ozonisator/OpenLRSng_SI4432/Bilder/OpenLRSng v0.2 Funkmodul.jpg

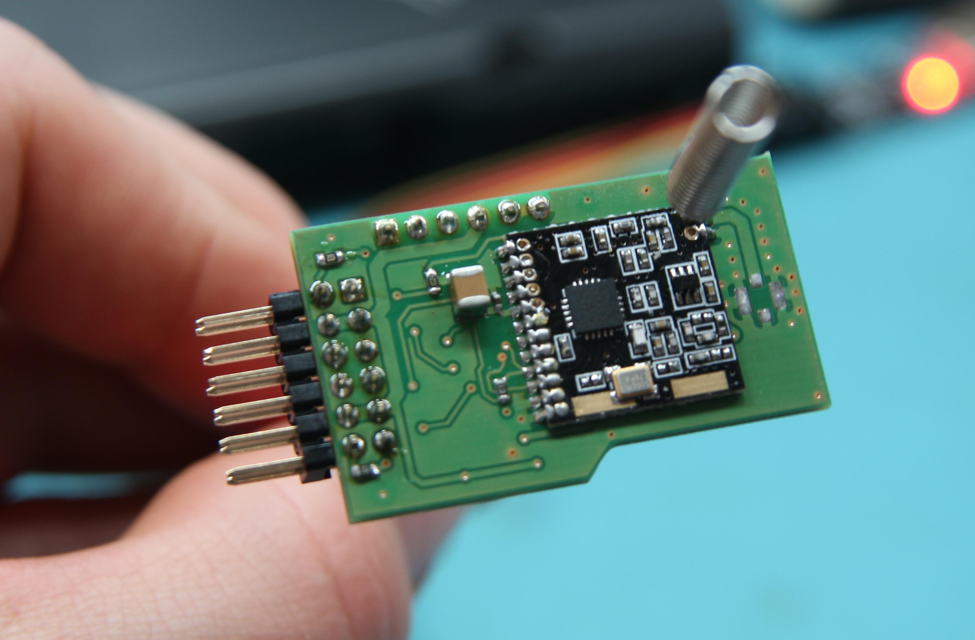
Bilder/OpenLRSng v0.2 Funkmodul.jpg
