ozonisator/OpenLRSng_SI4432/Bilder/OpenLRSng v0.2 Atmel.jpg

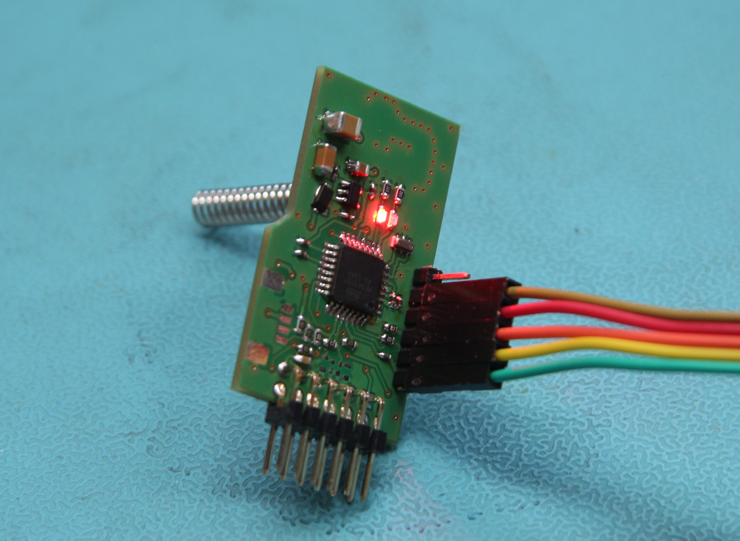
Bilder/OpenLRSng v0.2 Atmel.jpg
