ozonisator/OpenLRSng_SI4432/README.md

OpenLRSng Empfänger mit SI4432 Breakoutboard. Kompatibel zu "DTFUHF 4ch RX"
