ozonisator/OpenLRSng_SI4432/OpenLRSng_SI4432.pdf

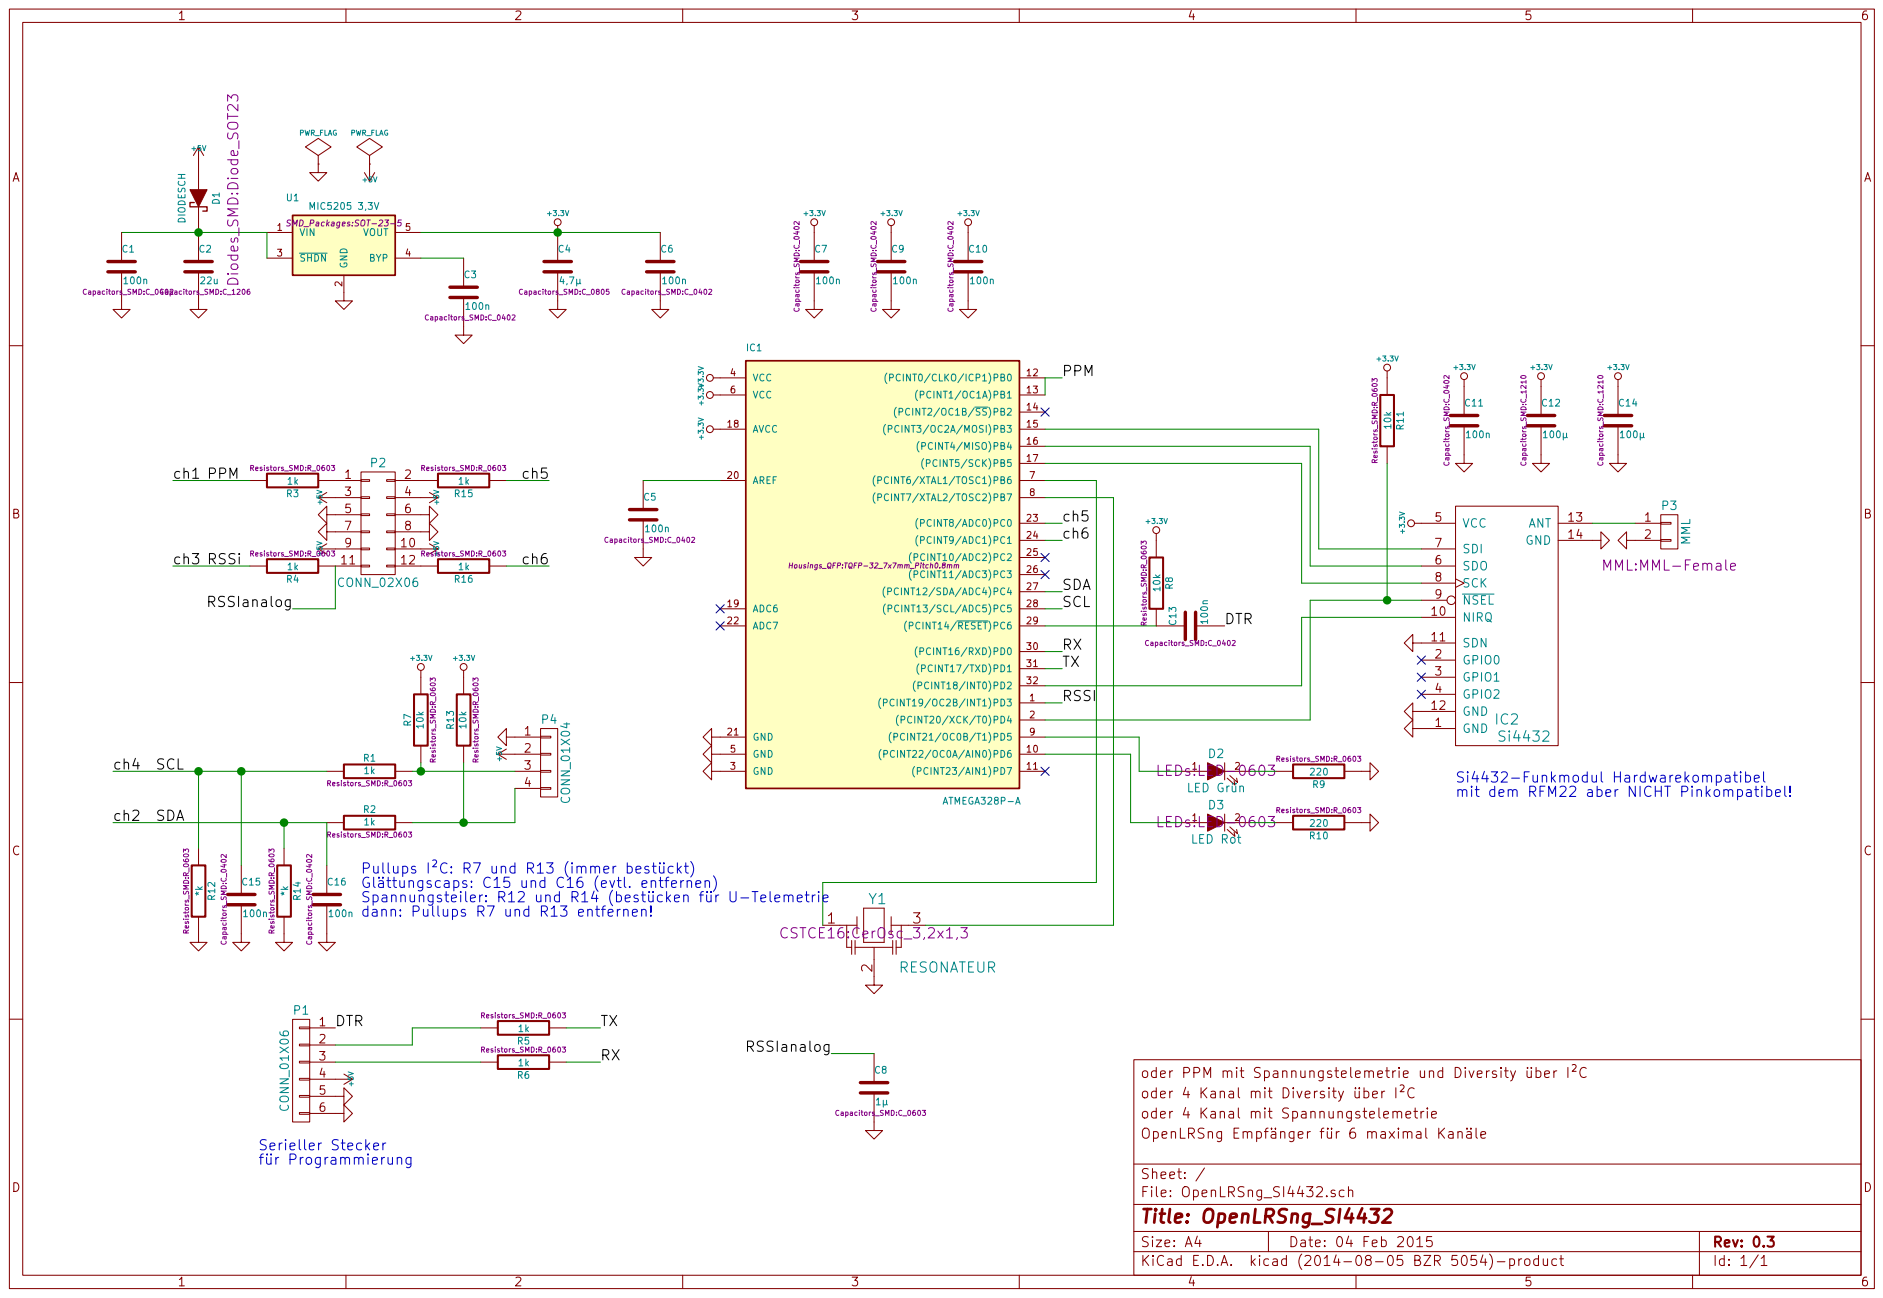
[picture p4: page 1]

dann: Pullups R7 und R13 entfernen! ch1

2 P3 MML MML:MML-Female

LED Grün LEDs:LED-0603

LED Rot LEDs:LED-0603

Glättungscaps: C15 und C16 (evtl. entfernen)
Spannungsteiler: R12 und R14 (bestücken für U-Telemetrie

oder PPM mit Spannungstelemetrie und Diversity über I²C
oder 4 Kanal mit Diversity über I²C
oder 4 Kanal mit Spannungstelemetrie
File: OpenLRSng_SI4432.sch Sheet: / OpenLRSng Empfänger für 6 maximal Kanäle
