ozonisator/OpenLRSng_SI4432/OpenLRSng_SI4432.kicad_pcb

## KiCad design OpenLRSng_SI4432.kicad_pcb (2015-02-28)

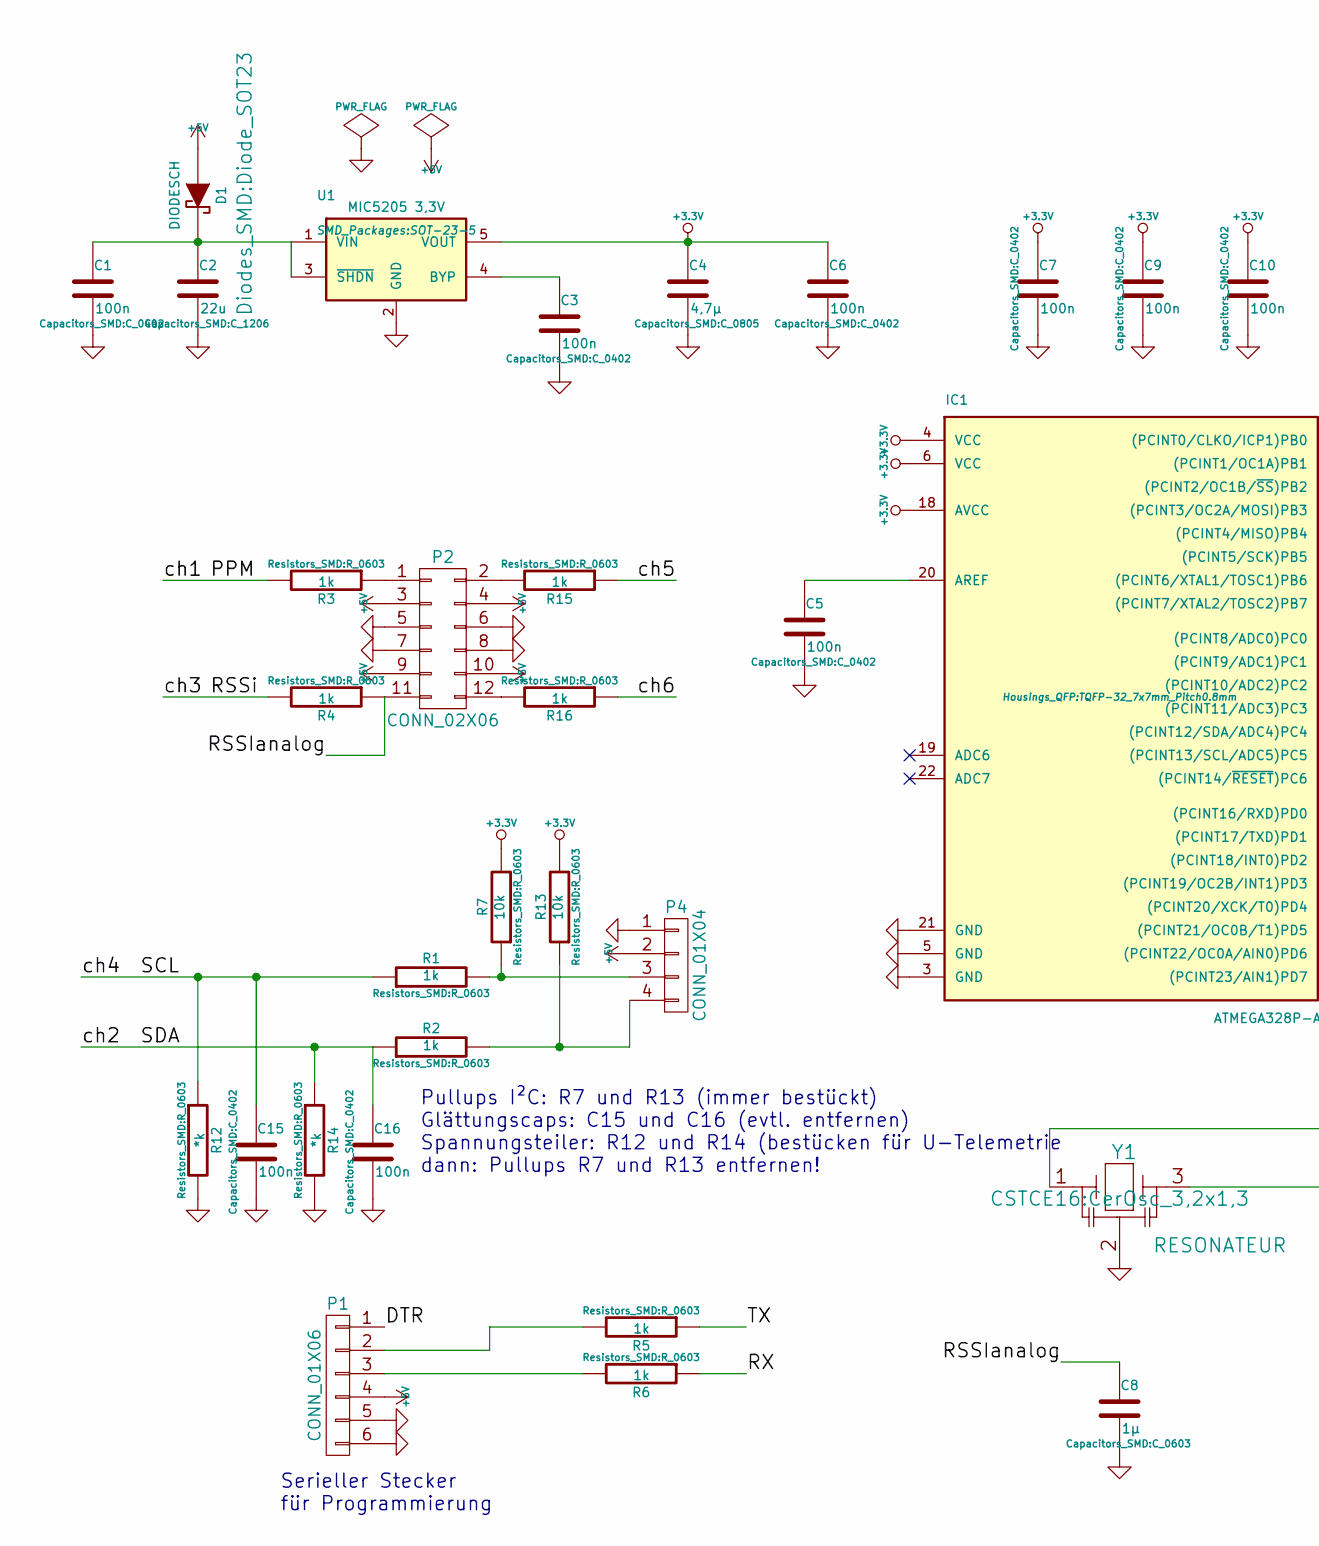
[picture p5: schematic OpenLRSng_SI4432.sch, part in row 1, column 1]

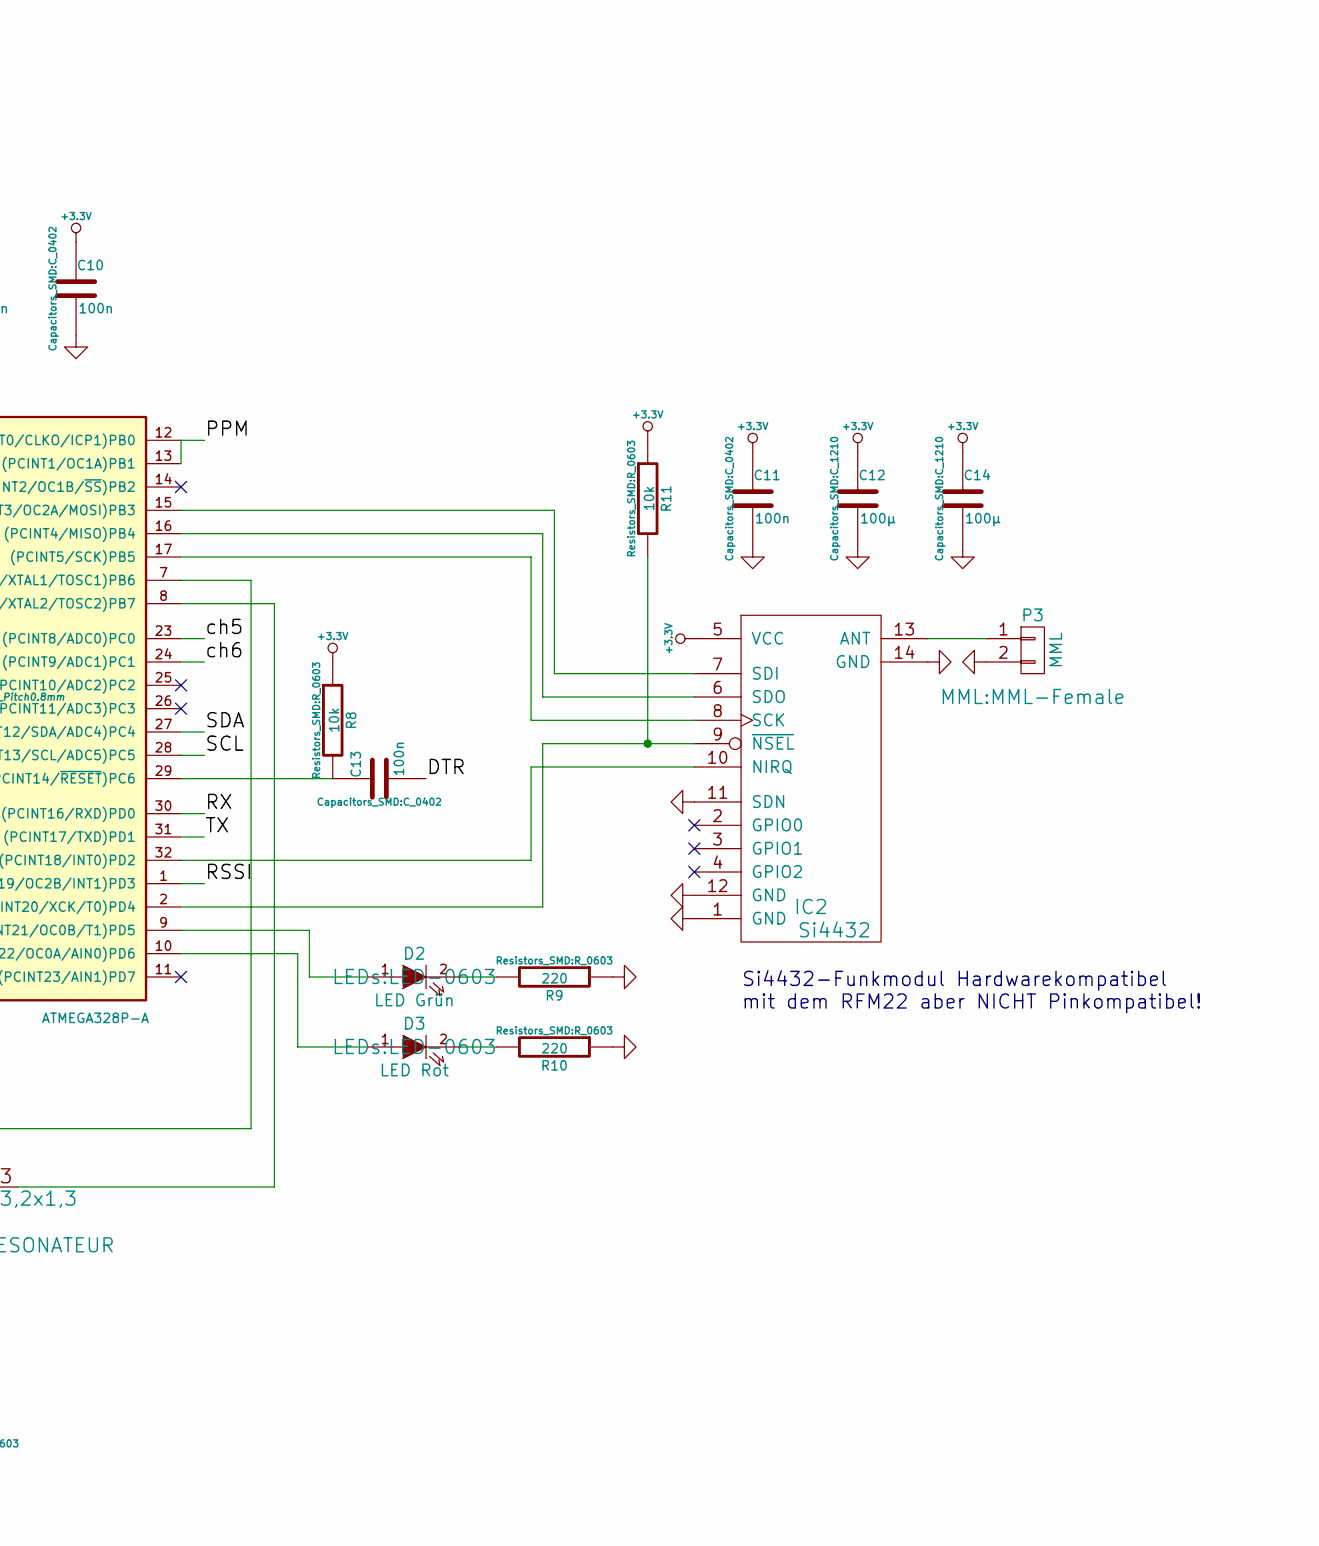
[picture p6: schematic OpenLRSng_SI4432.sch, part in row 1, column 2]

Parts:
C1, C3, C5, C6, C7, C9, C10, C11, C13, C15, C16: 100n; C_0402
C2: 22u; C_1206
C4: 4,7µ; C_0805
C8: 1µ; C_0603
C12, C14: 100µ; C_1210
D1: DIODESCH; Diode_SOT23
D2: LED Grün; LED-0603
D3: LED Rot; LED-0603
IC1: ATMEGA328P-A; TQFP-32_7x7mm_Pitch0.8mm
IC2: Si4432; SI4432_Module
P1: CONN_01X06; Pin_Header_Straight_1x06
P2: CONN_02X06; Pin_Header_Angled_2x06
P3: MML; MML-Female
P4: CONN_01X04; Connector_Molex_PicoBlade_53261-0471
R1, R2, R3, R4, R5, R6, R15, R16: 1k; R_0603
R7, R8, R11, R13: 10k; R_0603
R9, R10: 220; R_0603
R12, R14: *k; R_0603
U1: MIC5205 3,3V; SOT-23-5
Y1: RESONATEUR; CerOsc_3,2x1,3

Connections:
+3.3V: C4.1, C6.1, C7.1, C9.1, C10.1, C11.1, C12.1, C14.1, IC1.4 (VCC), IC1.6 (VCC), IC1.18 (AVCC), IC2.5 (VCC), R7.2, R8.1, R11.1, R13.2, U1.5 (VOUT)
+5V: D1.1 (A), P1.4, P2.3, P2.4, P2.9, P2.10, P4.2
/DTR: C13.2, P1.1
/PPM: IC1.12 ((PCINT0/CLKO/ICP1)PB0), IC1.13 ((PCINT1/OC1A)PB1), R3.2
/RSSI: IC1.1 ((PCINT19/OC2B/INT1)PD3), R4.2
/RSSIanalog: C8.1, P2.11, R4.1
/RX: IC1.30 ((PCINT16/RXD)PD0), R6.1
/SCL: C15.1, IC1.28 ((PCINT13/SCL/ADC5)PC5), R1.1, R12.1
/SDA: C16.1, IC1.27 ((PCINT12/SDA/ADC4)PC4), R2.1, R14.1
/TX: IC1.31 ((PCINT17/TXD)PD1), R5.1
/ch5: IC1.23 ((PCINT8/ADC0)PC0), R15.1
/ch6: IC1.24 ((PCINT9/ADC1)PC1), R16.1
GND: C1.2, C2.2, C3.2, C4.2, C5.2, C6.2, C7.2, C8.2, C9.2, C10.2, C11.2, C12.2, C14.2, C15.2, C16.2, IC1.3 (GND), IC1.5 (GND), IC1.21 (GND), IC2.1 (GND), IC2.11 (SDN), IC2.12 (GND), IC2.14 (GND), P1.5, P1.6, P2.5, P2.6, P2.7, P2.8, P3.2, P4.1, R9.1, R10.1, R12.2, R14.2, U1.2 (GND), Y1.2
unnamed: C1.1, C2.1, D1.2 (K), U1.1 (VIN), U1.3 (~SHDN~)
unnamed: C3.1, U1.4 (BYP)
unnamed: C5.1, IC1.20 (AREF)
unnamed: C13.1, IC1.29 ((PCINT14/~RESET~)PC6), R8.2
unnamed: D2.1 (A), IC1.9 ((PCINT21/OC0B/T1)PD5)
unnamed: D2.2 (K), R9.2
unnamed: D3.1 (A), IC1.10 ((PCINT22/OC0A/AIN0)PD6)
unnamed: D3.2 (K), R10.2
unnamed: IC1.2 ((PCINT20/XCK/T0)PD4), IC2.9 (~NSEL), R11.2
unnamed: IC1.7 ((PCINT6/XTAL1/TOSC1)PB6), Y1.1
unnamed: IC1.8 ((PCINT7/XTAL2/TOSC2)PB7), Y1.3
unnamed: IC1.15 ((PCINT3/OC2A/MOSI)PB3), IC2.7 (SDI)
unnamed: IC1.16 ((PCINT4/MISO)PB4), IC2.6 (SDO)
unnamed: IC1.17 ((PCINT5/SCK)PB5), IC2.8 (SCK)
unnamed: IC1.32 ((PCINT18/INT0)PD2), IC2.10 (NIRQ)
unnamed: IC2.13 (ANT), P3.1
unnamed: P1.2, R5.2
unnamed: P1.3, R6.2
unnamed: P2.1, R3.1
unnamed: P2.2, R15.2
unnamed: P2.12, R16.2
unnamed: P4.3, R1.2, R7.1
unnamed: P4.4, R2.2, R13.1

Notes on the sheet:
Serieller Stecker für Programmierung
Si4432-Funkmodul Hardwarekompatibel mit dem RFM22 aber NICHT Pinkompatibel!
Pullups I²C: R7 und R13 (immer bestückt) Glättungscaps: C15 und C16 (evtl. entfernen) Spannungsteiler: R12 und R14 (bestücken für U-Telemetrie dann: Pullups R7 und R13 entfernen!

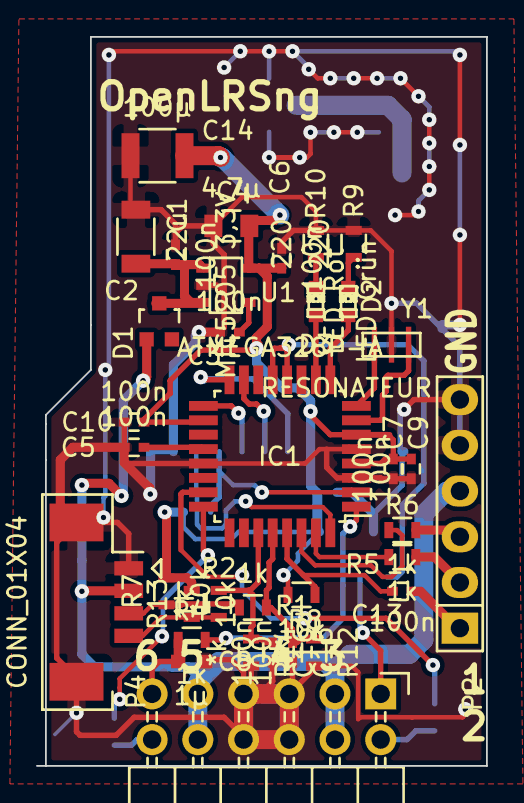
[picture p7: board OpenLRSng_SI4432.kicad_pcb from above]

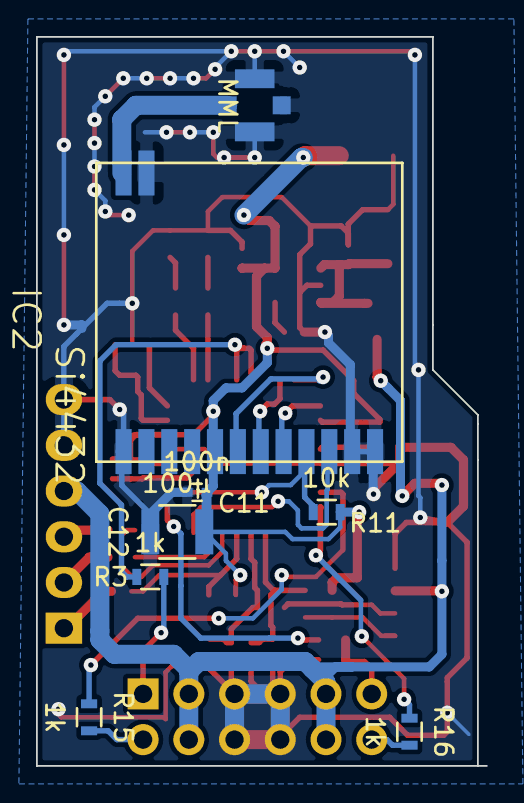
[picture p8: board OpenLRSng_SI4432.kicad_pcb from below]

Board: 2 copper layers, 25.0 x 40.5 mm, 43 parts (8 on the bottom side), 36 nets.
