ozonisator/OpenLRSng_SI4432/(commit log)

2015-02-01 OpenLRSng Empfänger mit Si4432 Breakout Board, Layout identisch zu DTFUHF 4 Kanal Empfänger
    [OpenLRSng_SI4432-B_Cu.gbl, OpenLRSng_SI4432-B_Mask.gbs, OpenLRSng_SI4432-B_SilkS.gbo, OpenLRSng_SI4432-Edge_Cuts.gbr, OpenLRSng_SI4432-F_Cu.gtl, OpenLRSng_SI4432-F_Mask.gts, OpenLRSng_SI4432-F_SilkS.gto, OpenLRSng_SI4432-drl_map.gbr]
2015-02-03 100uF Cap von 1206 auf 1210 geändert
    [OpenLRSng_SI4432-B_Cu.gbl, OpenLRSng_SI4432-B_Mask.gbs, OpenLRSng_SI4432-B_SilkS.gbo, OpenLRSng_SI4432-Edge_Cuts.gbr, OpenLRSng_SI4432-F_Cu.gtl, OpenLRSng_SI4432-F_Mask.gts, OpenLRSng_SI4432-F_SilkS.gto, OpenLRSng_SI4432-drl_map.gbr]
2015-02-04 -SI4432 Bibliothek gefixt (Pin14 GND vergessen im Schaltplan) -DuKo Kupferfläche vergrößert -zusätzlich noch einmal 100uF Kerko an die 3,3V Rail -Via Stichting an der Massefläche
    [OpenLRSng_SI4432.kicad_pcb, OpenLRSng_SI4432.sch]
2015-02-04 entferne redundanz...
    [OpenLRSng_SI4432-B_Cu.gbl, OpenLRSng_SI4432-B_Mask.gbs, OpenLRSng_SI4432-B_SilkS.gbo, OpenLRSng_SI4432-Edge_Cuts.gbr, OpenLRSng_SI4432-F_Cu.gtl, OpenLRSng_SI4432-F_Mask.gts, OpenLRSng_SI4432-F_SilkS.gto, OpenLRSng_SI4432-drl_map.gbr]
2015-02-05 Schaltplan aktualisiert
    [OpenLRSng_SI4432-B_Cu.gbl, OpenLRSng_SI4432-B_Mask.gbs, OpenLRSng_SI4432-B_SilkS.gbo, OpenLRSng_SI4432-Edge_Cuts.gbr, OpenLRSng_SI4432-F_Cu.gtl, OpenLRSng_SI4432-F_Mask.gts, OpenLRSng_SI4432-F_SilkS.gto, OpenLRSng_SI4432-drl_map.gbr]
2015-02-05 gerber ordner richtig angelegt
2015-02-06 4 Kanal auf 6 Kanal umgebaut und leicht optimiert
    [OpenLRSng_SI4432.kicad_pcb, OpenLRSng_SI4432.sch]
2015-02-06 pdf-Schaltplan aktualisiert
    [OpenLRSng_SI4432.sch]
2015-02-24 Von 6 auf 4 Kanäle reduziert, I2C oder Analog in der Zusätzliche Kanäle über PicoBlade, Spannungsteiler/Pullup/Schutzwiderstandspads
    [OpenLRSng_SI4432.sch]
2015-02-24 Tiefpassfilter Cap an den Analog Inputs nachgerüstet
    [OpenLRSng_SI4432.sch]
2015-02-24 Spannungsteiler korrigiert...
    [OpenLRSng_SI4432.sch]
2015-02-24 Schaltplan finalisiert, I²C-Stecker nach APM-Standard angebracht
    [OpenLRSng_SI4432.sch]
2015-02-27 picoblade dazu und layout etwas weiter. noch unfertig.
    [OpenLRSng_SI4432.kicad_pcb, OpenLRSng_SI4432.sch]
2015-02-28 I²C Stecker im APM-Layout dazugefügt und Layout soweit fertig gemacht
    [OpenLRSng_SI4432.kicad_pcb, OpenLRSng_SI4432.sch]
2015-02-28 schaltplan als pdf exportiert und aktualisiert
2015-03-22 code als submodul dazugefügt und ein paar Bilder eines Moduls eingbaut
    [AStyle.cfg]
